MaslowCommunityGarden/Big-Z-value-display/mainpicture.jpg

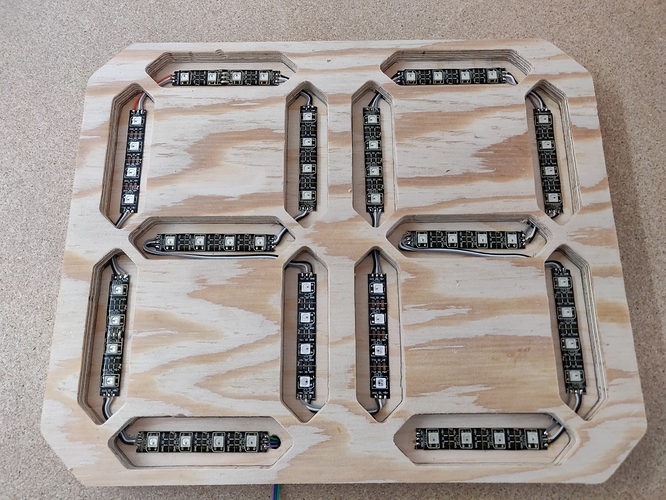
mainpicture.jpg
