MaslowCommunityGarden/Big-Z-value-display/README.md

# Big Z-value display

Be able to see the current Z value of your maslow from all over the workshop
