MaslowCommunityGarden/Big-Z-value-display/BOM.md

Edit this file to add a bill of materials

You can find instructions on how to edit this page on the community garden meta page [here](http://maslowcommunitygarden.org/Website.html?instructions=true)

The style cheat sheet [here](https://github.com/adam-p/markdown-here/wiki/Markdown-Cheatsheet) is useful
