MaslowCommunityGarden/Big-Z-value-display/Z Display Back.dxf

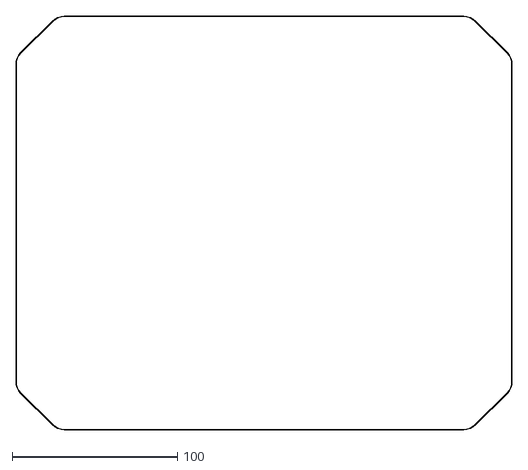
[picture p2: CAD file, 2018-08-10]
Z Display Back.dxf
300.0 x 250.0
