MaslowCommunityGarden/Big-Z-value-display/Z Display Front.dxf

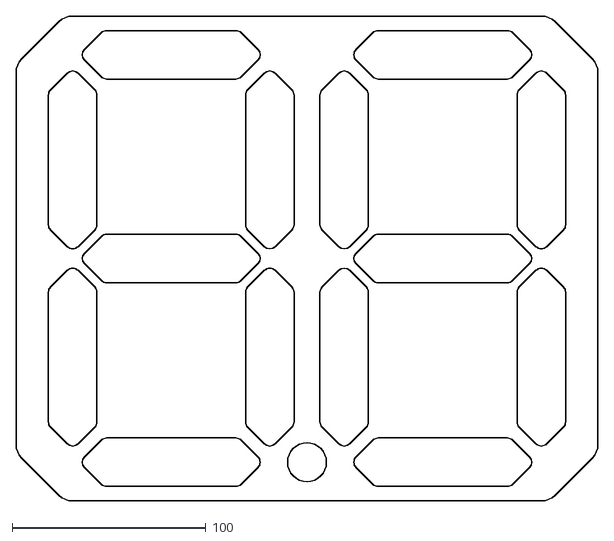
[picture p3: CAD file, 2018-08-10]
Z Display Front.dxf
300.0 x 250.0
